AdmondDeng/remote/case/Assem1.SLDASM

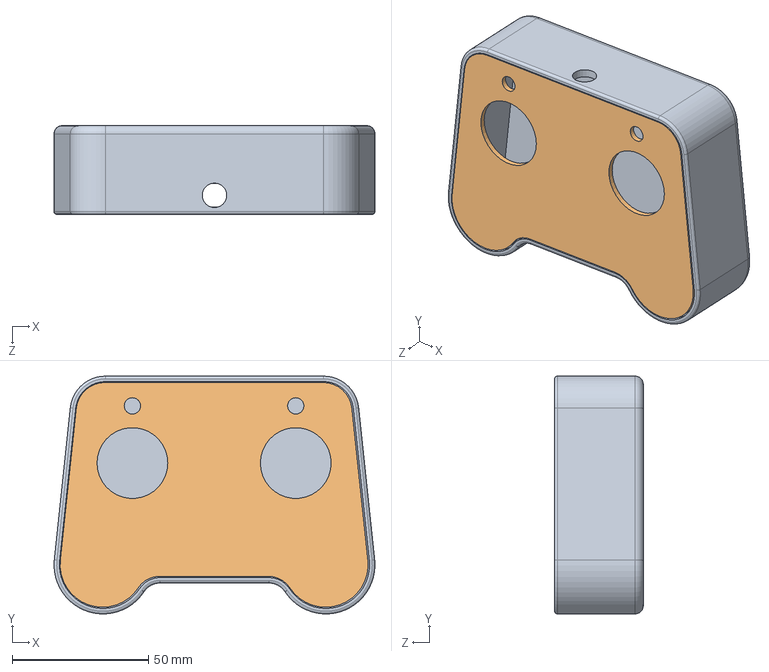
[picture p1: CAD file, 2024-06-24]
case/Assem1.SLDASM
117.9 x 87.3 x 32.6 mm
