AdmondDeng/remote/case/upper.SLDPRT

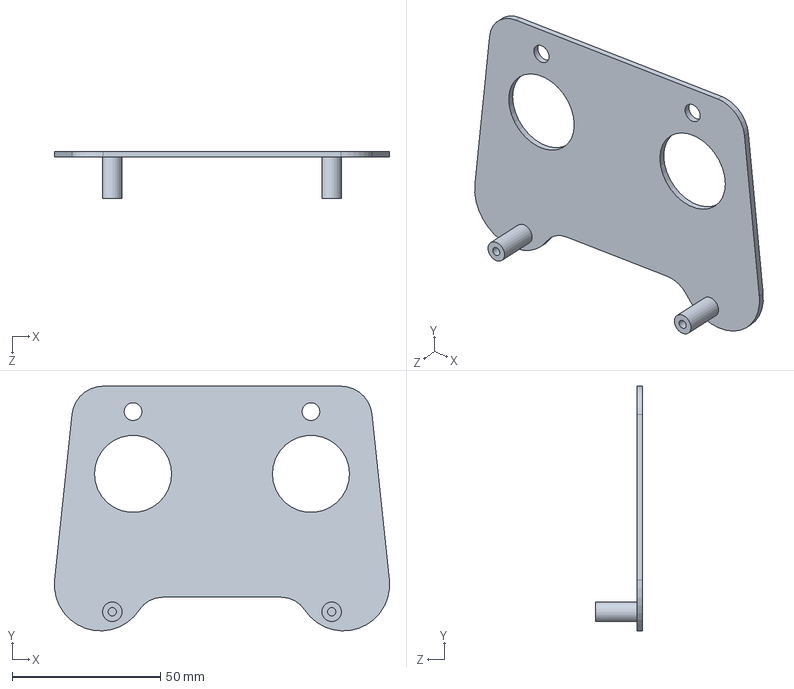
[picture p2: CAD file, 2024-06-24]
case/upper.SLDPRT
113.0 x 82.5 x 16.0 mm
