AdmondDeng/remote/case/lower - backup.SLDPRT

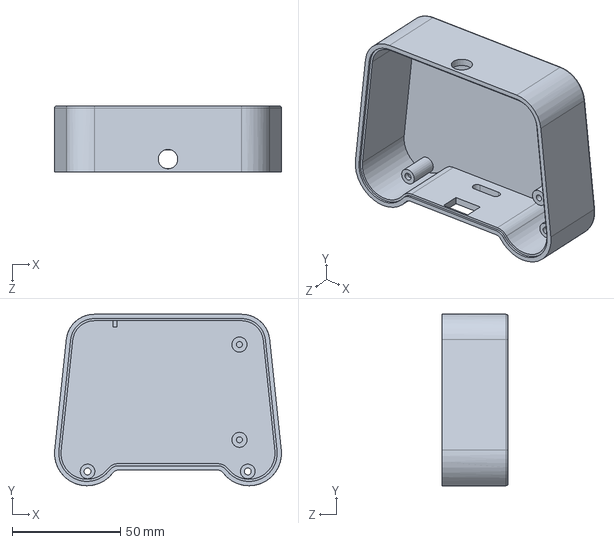
[picture p3: CAD file, 2024-06-24]
case/lower - backup.SLDPRT
104.8 x 79.2 x 30.6 mm
