AdmondDeng/remote/case/lower.SLDPRT

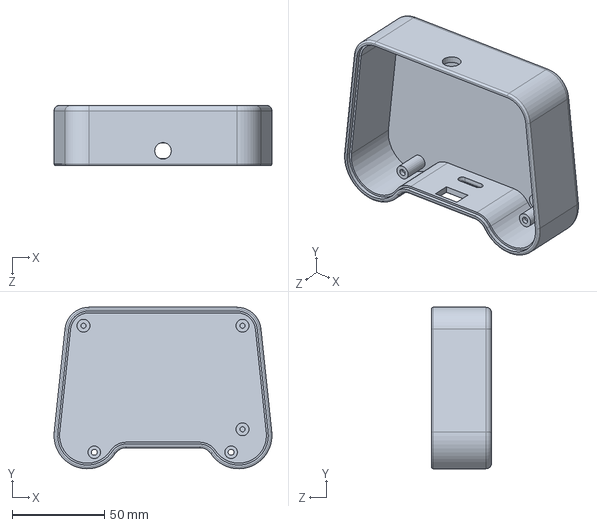
[picture p4: CAD file, 2024-06-24]
case/lower.SLDPRT
117.9 x 87.4 x 32.6 mm
