AdmondDeng/remote/Hw_Transmitter/transmitter/transmitter.kicad_pcb

## KiCad design Hw_Transmitter/transmitter/transmitter.kicad_pcb (2024-06-27)

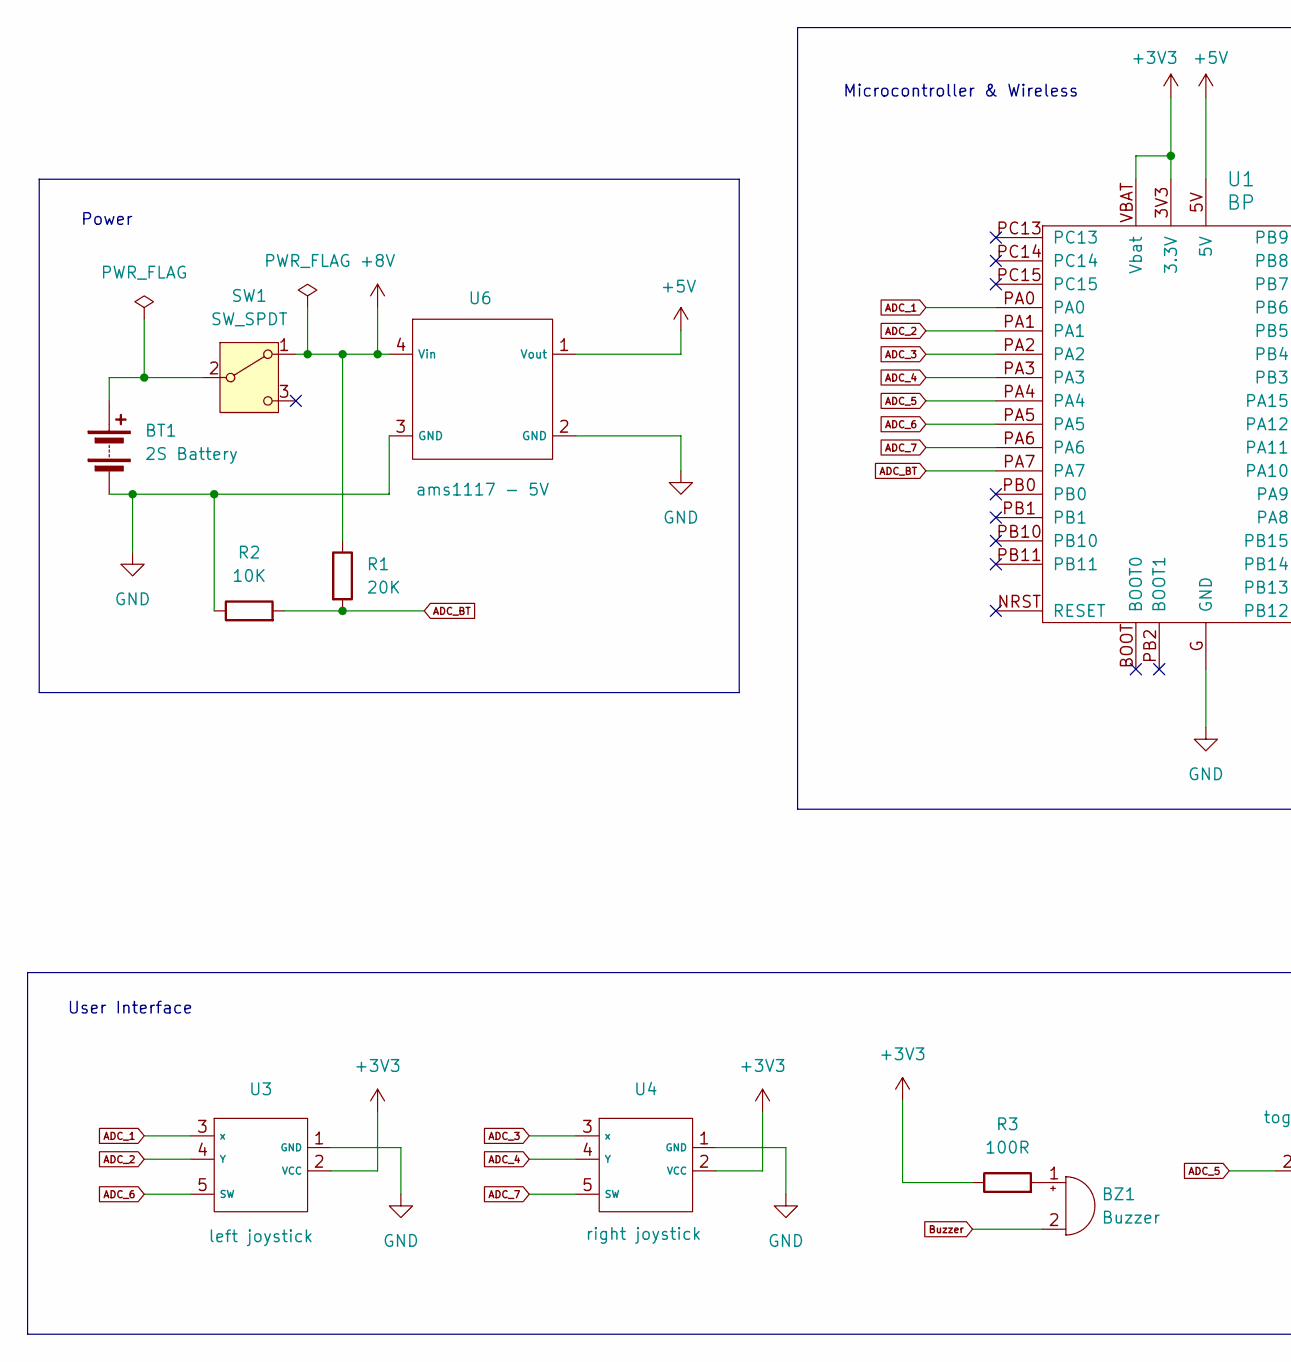
[picture p5: schematic transmitter.kicad_sch, part in row 1, column 1]

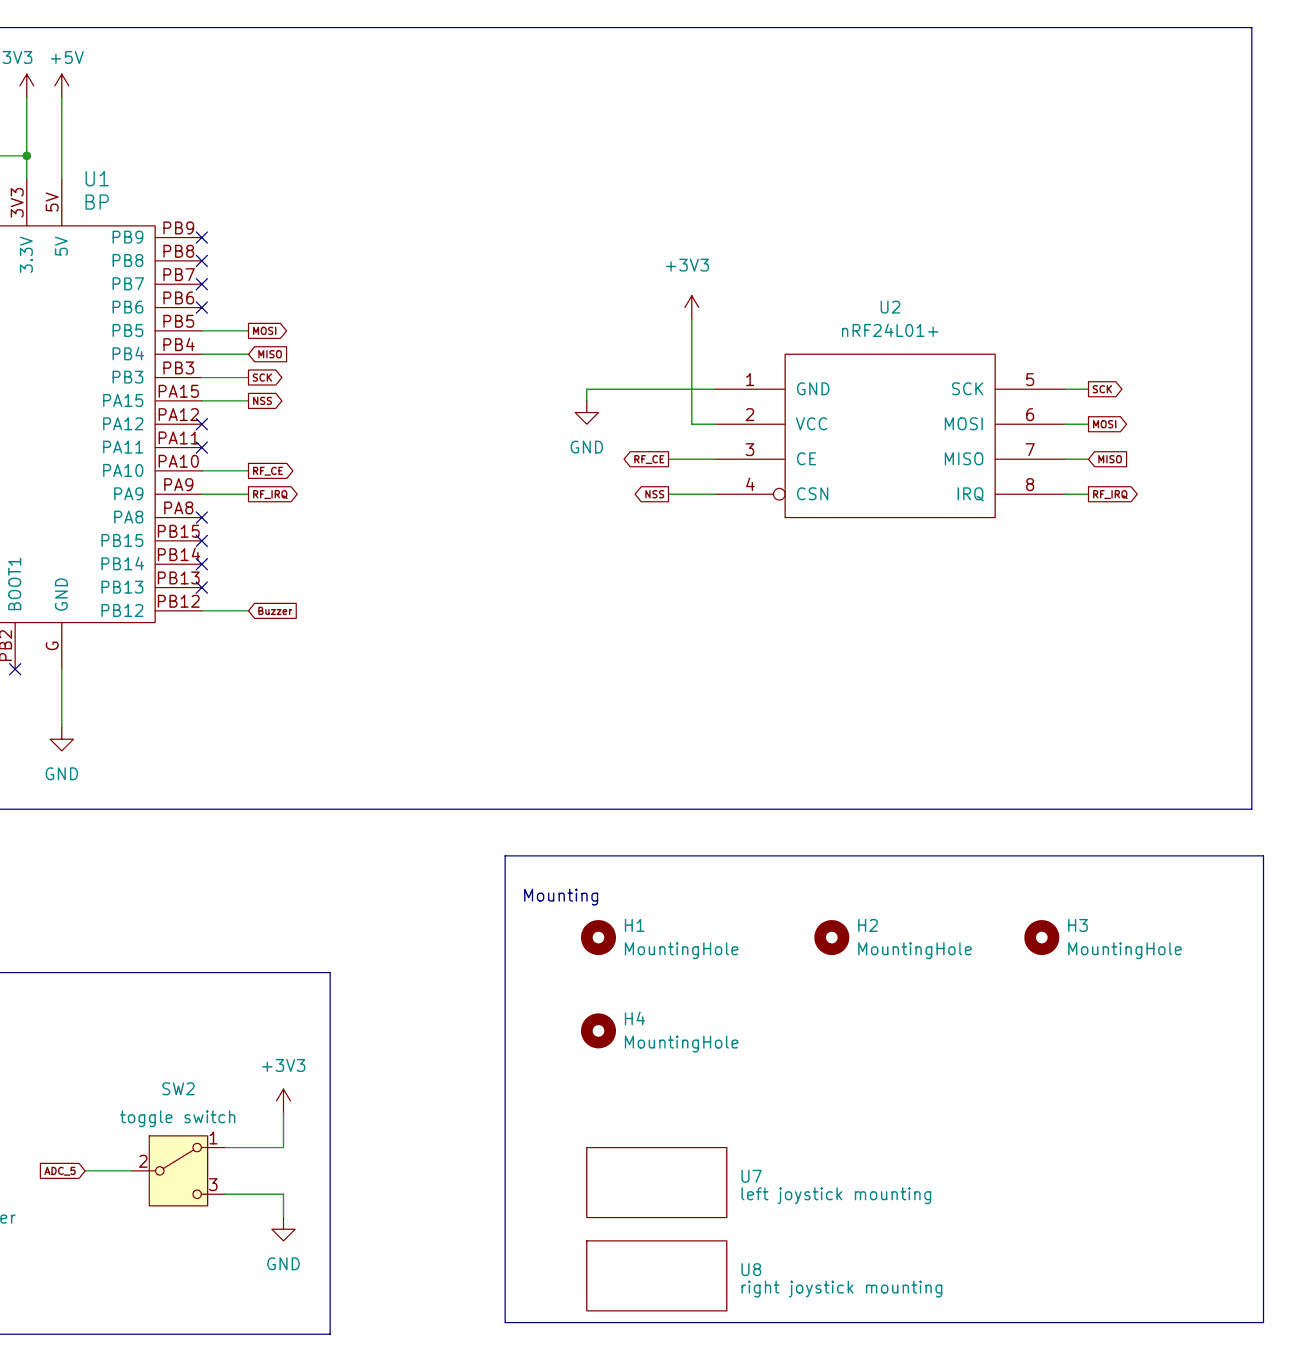
[picture p6: schematic transmitter.kicad_sch, part in row 1, column 2]

Parts:
BT1: 2S Battery; R_2816_7142Metric_Pad3.20x4.45mm_HandSolder
BZ1: Buzzer; buzzer
H1, H2, H3, H4: MountingHole; MountingHole_3.2mm_M3
R1: 20K; R_Axial_DIN0207_L6.3mm_D2.5mm_P10.16mm_Horizontal
R2: 10K; R_Axial_DIN0207_L6.3mm_D2.5mm_P10.16mm_Horizontal
R3: 100R; R_Axial_DIN0207_L6.3mm_D2.5mm_P10.16mm_Horizontal
SW1: SW_SPDT; toggle_switch
SW2: toggle switch; toggle_switch
U1: BP; blue_pill
U2: nRF24L01+; PinHeader_2x04_P2.54mm_Vertical
U3: left joystick; PinHeader_1x05_P2.54mm_Vertical
U4: right joystick; PinHeader_1x05_P2.54mm_Vertical
U6: ams1117 - 5V; ams1117_module
U7: left joystick mounting; joystick_mounting
U8: right joystick mounting; joystick_mounting

Connections:
+3V3: R3.1, SW2.1 (A), U1.3V3 (3.3V), U1.VBAT (Vbat), U2.2 (VCC), U3.2 (VCC), U4.2 (VCC)
+5V: U1.5V, U6.1 (Vout)
+8V: R1.1, SW1.1 (A), U6.4 (Vin)
ADC_1: U1.PA0, U3.3 (x)
ADC_2: U1.PA1, U3.4 (Y)
ADC_3: U1.PA2, U4.3 (x)
ADC_4: U1.PA3, U4.4 (Y)
ADC_5: SW2.2 (B), U1.PA4
ADC_6: U1.PA5, U3.5 (SW)
ADC_7: U1.PA6, U4.5 (SW)
ADC_BT: R1.2, R2.2, U1.PA7
Buzzer: BZ1.2 (-), U1.PB12
GND: BT1.2 (-), R2.1, SW2.3 (C), U1.G (GND), U2.1 (GND), U3.1 (GND), U4.1 (GND), U6.2 (GND), U6.3 (GND)
MISO: U1.PB4, U2.7 (MISO)
MOSI: U1.PB5, U2.6 (MOSI)
NSS: U1.PA15, U2.4 (CSN)
unnamed: BT1.1 (+), SW1.2 (B)
unnamed: BZ1.1 (+), R3.2
RF_CE: U1.PA10, U2.3 (CE)
RF_IRQ: U1.PA9, U2.8 (IRQ)
SCK: U1.PB3, U2.5 (SCK)

Notes on the sheet:
Power
Microcontroller & Wireless
User Interface
Mounting

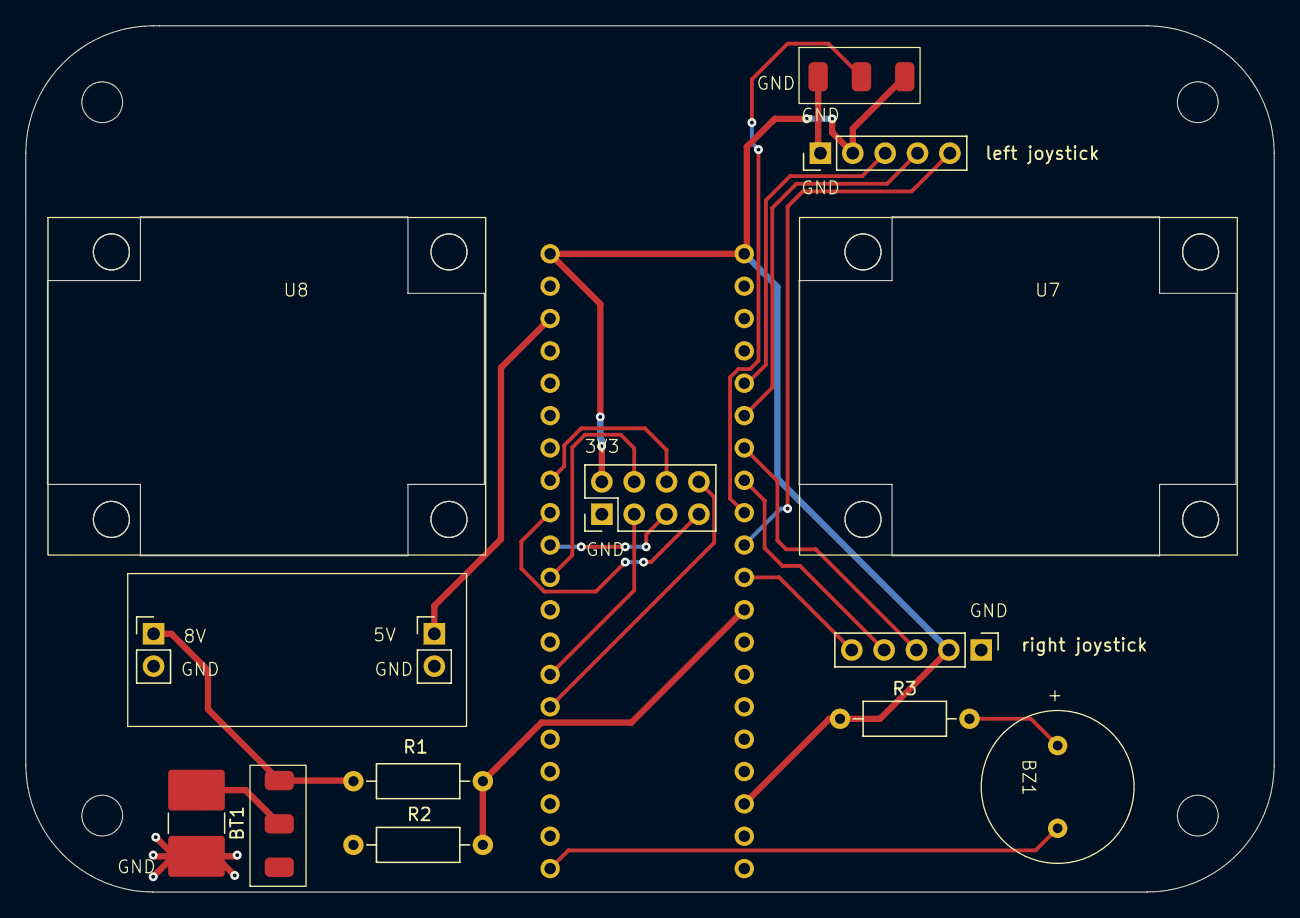
[picture p7: board transmitter.kicad_pcb from above]

Board: 2 copper layers, 98.0 x 68.0 mm, 18 parts (1 on the bottom side), 21 nets.
