AdmondDeng/remote/Hw_Receiver/receiver/receiver.kicad_pcb

## KiCad design Hw_Receiver/receiver/receiver.kicad_pcb (2024-06-24)

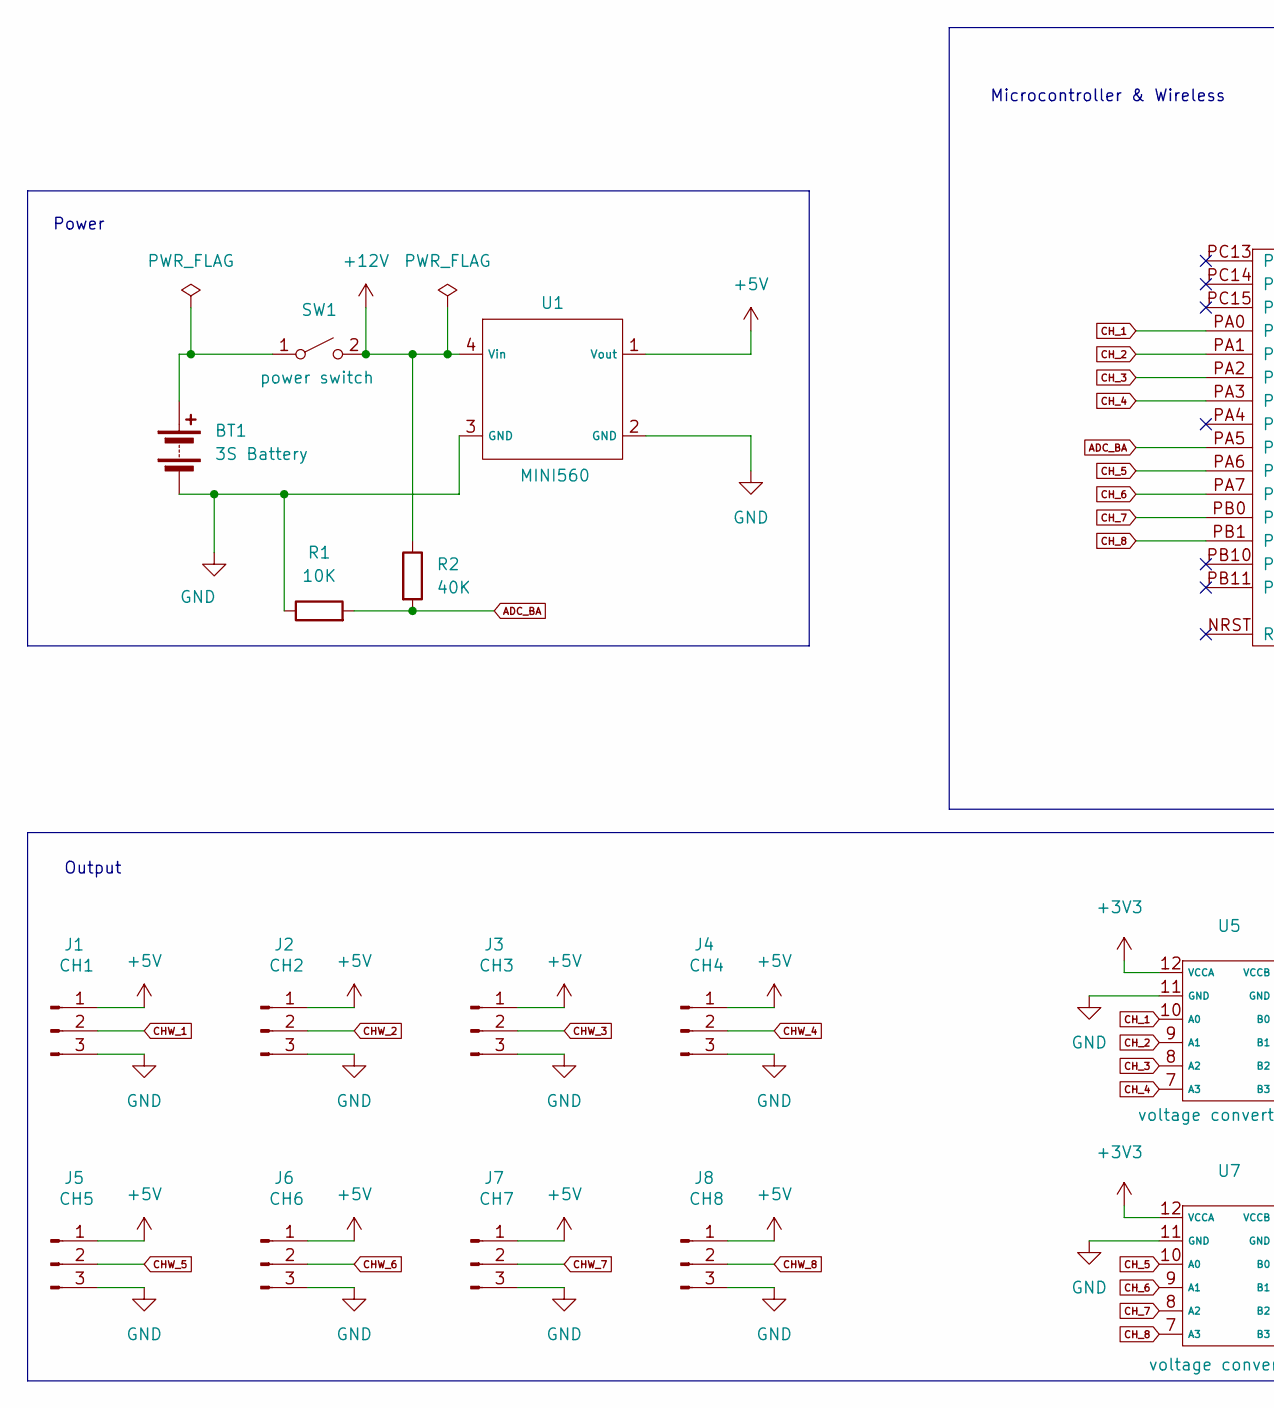
[picture p8: schematic receiver.kicad_sch, part in row 1, column 1]

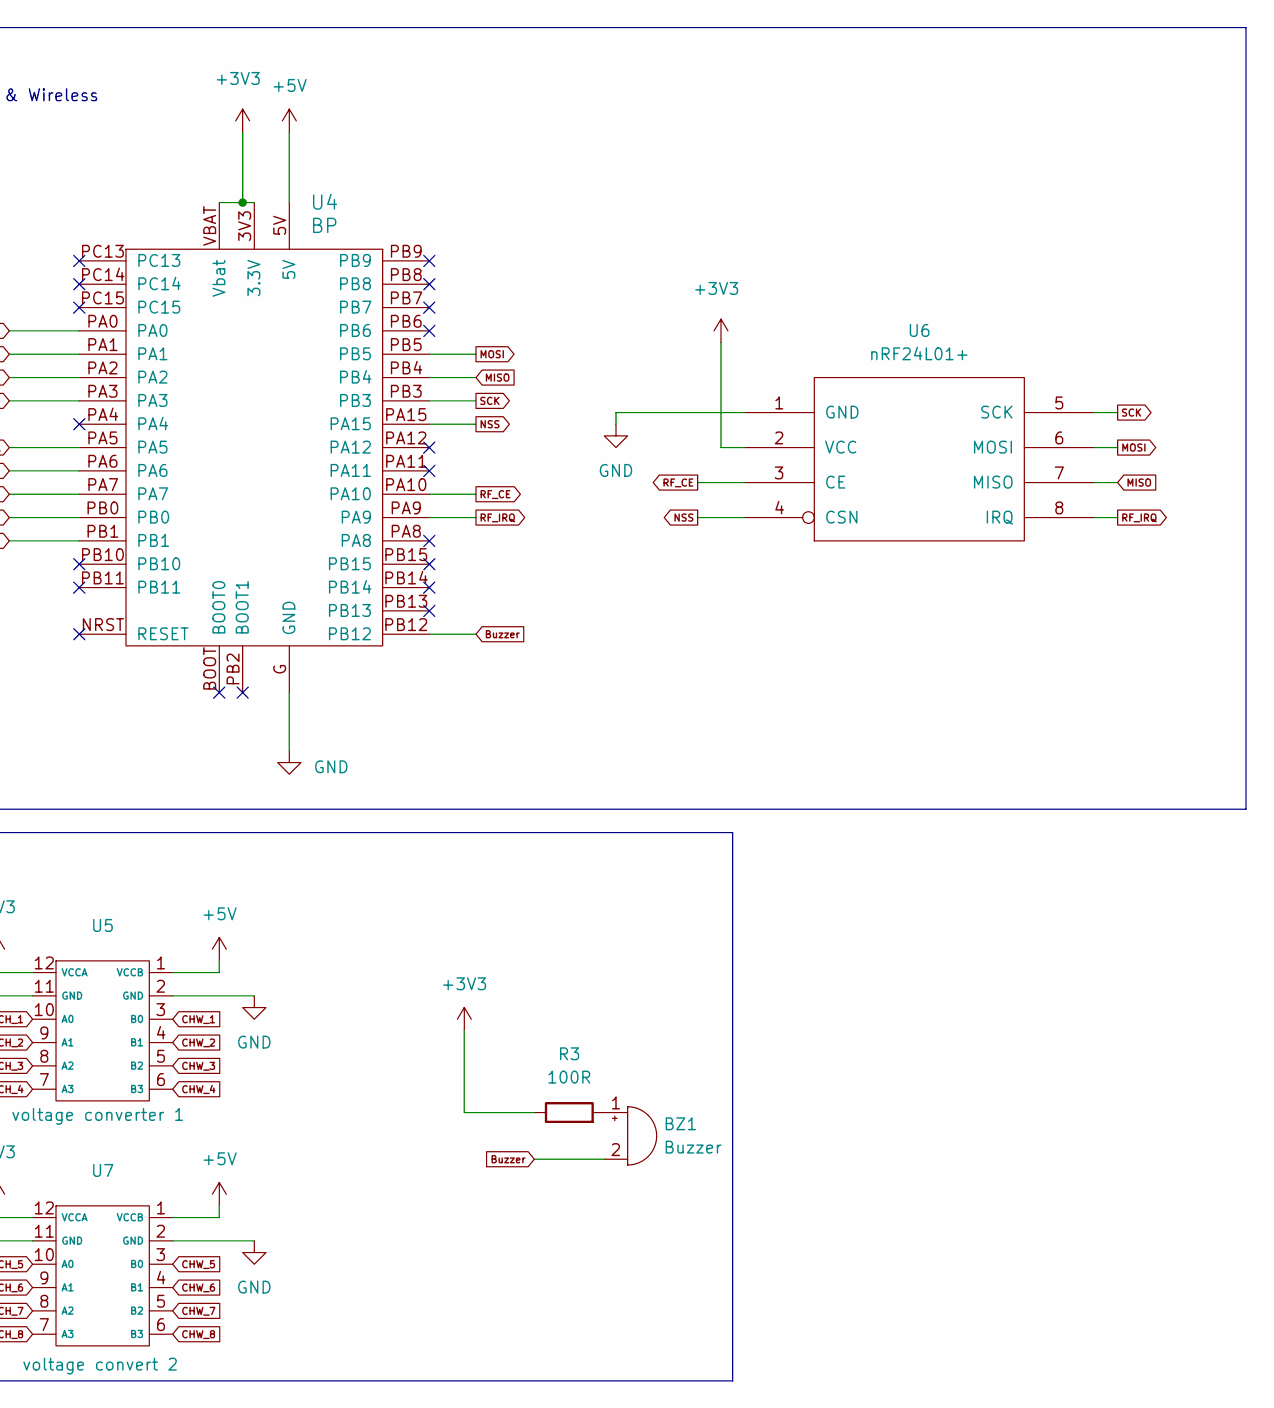
[picture p9: schematic receiver.kicad_sch, part in row 1, column 2]

Parts:
BT1: 3S Battery; R_2816_7142Metric_Pad3.20x4.45mm_HandSolder
BZ1: Buzzer; buzzer
J1: CH1; PinHeader_1x03_P2.54mm_Vertical
J2: CH2; PinHeader_1x03_P2.54mm_Vertical
J3: CH3; PinHeader_1x03_P2.54mm_Vertical
J4: CH4; PinHeader_1x03_P2.54mm_Vertical
J5: CH5; PinHeader_1x03_P2.54mm_Vertical
J6: CH6; PinHeader_1x03_P2.54mm_Vertical
J7: CH7; PinHeader_1x03_P2.54mm_Vertical
J8: CH8; PinHeader_1x03_P2.54mm_Vertical
R1: 10K; R_Axial_DIN0207_L6.3mm_D2.5mm_P10.16mm_Horizontal
R2: 40K; R_Axial_DIN0207_L6.3mm_D2.5mm_P10.16mm_Horizontal
R3: 100R; R_Axial_DIN0207_L6.3mm_D2.5mm_P10.16mm_Horizontal
SW1: power switch; R_2816_7142Metric_Pad3.20x4.45mm_HandSolder
U1: MINI560; mini560
U4: BP; blue_pill
U5: voltage converter 1; 3v_5v_converter
U6: nRF24L01+; PinHeader_2x04_P2.54mm_Vertical
U7: voltage convert 2; 3v_5v_converter

Connections:
+3V3: R3.1, U4.3V3 (3.3V), U4.VBAT (Vbat), U5.12 (VCCA), U6.2 (VCC), U7.12 (VCCA)
+5V: J1.1, J2.1, J3.1, J4.1, J5.1, J6.1, J7.1, J8.1, U1.1 (Vout), U4.5V, U5.1 (VCCB), U7.1 (VCCB)
+12V: R2.1, SW1.2 (B), U1.4 (Vin)
ADC_BA: R1.2, R2.2, U4.PA5
Buzzer: BZ1.2 (-), U4.PB12
CHW_1: J1.2, U5.3 (B0)
CHW_2: J2.2, U5.4 (B1)
CHW_3: J3.2, U5.5 (B2)
CHW_4: J4.2, U5.6 (B3)
CHW_5: J5.2, U7.3 (B0)
CHW_6: J6.2, U7.4 (B1)
CHW_7: J7.2, U7.5 (B2)
CHW_8: J8.2, U7.6 (B3)
CH_1: U4.PA0, U5.10 (A0)
CH_2: U4.PA1, U5.9 (A1)
CH_3: U4.PA2, U5.8 (A2)
CH_4: U4.PA3, U5.7 (A3)
CH_5: U4.PA6, U7.10 (A0)
CH_6: U4.PA7, U7.9 (A1)
CH_7: U4.PB0, U7.8 (A2)
CH_8: U4.PB1, U7.7 (A3)
GND: BT1.2 (-), J1.3, J2.3, J3.3, J4.3, J5.3, J6.3, J7.3, J8.3, R1.1, U1.2 (GND), U1.3 (GND), U4.G (GND), U5.2 (GND), U5.11 (GND), U6.1 (GND), U7.2 (GND), U7.11 (GND)
MISO: U4.PB4, U6.7 (MISO)
MOSI: U4.PB5, U6.6 (MOSI)
NSS: U4.PA15, U6.4 (CSN)
unnamed: BT1.1 (+), SW1.1 (A)
unnamed: BZ1.1 (+), R3.2
RF_CE: U4.PA10, U6.3 (CE)
RF_IRQ: U4.PA9, U6.8 (IRQ)
SCK: U4.PB3, U6.5 (SCK)

Notes on the sheet:
Output
Power
Microcontroller & Wireless

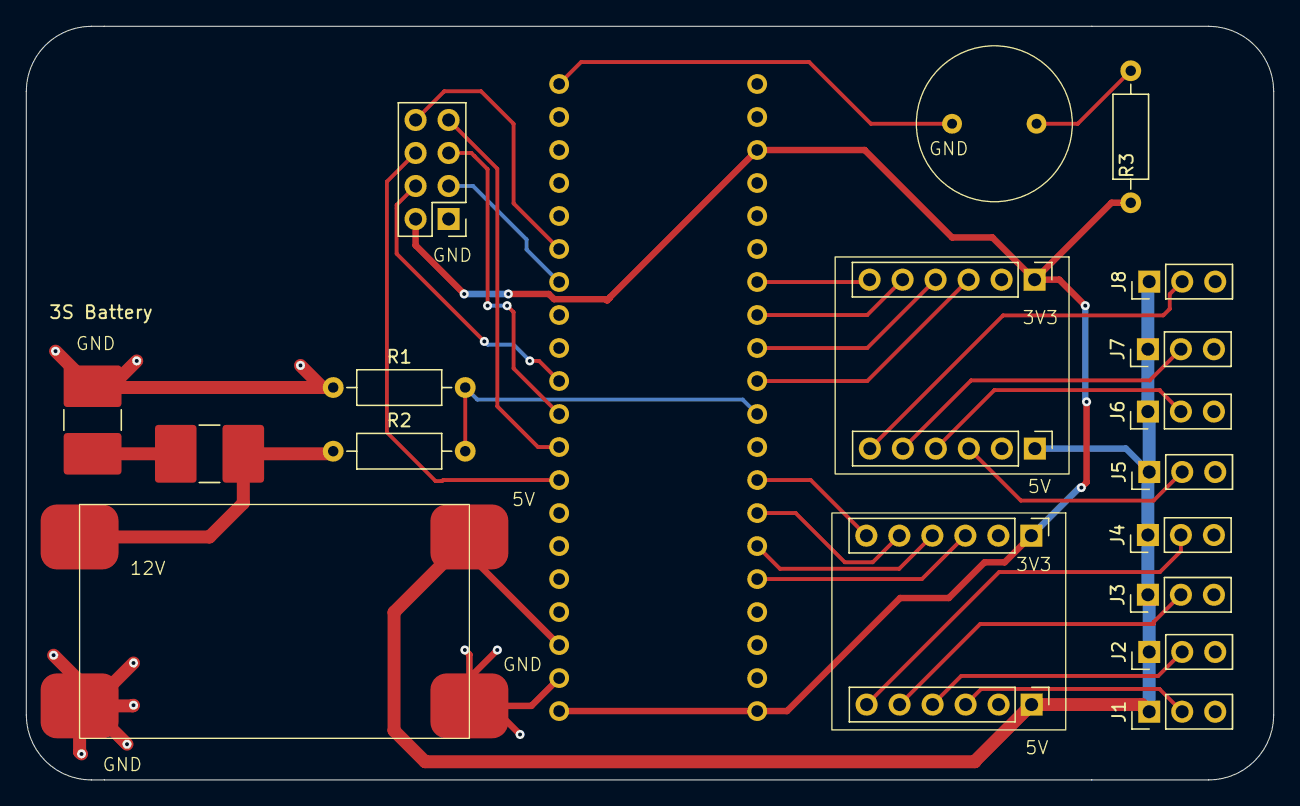
[picture p10: board receiver.kicad_pcb from above]

Board: 2 copper layers, 96.0 x 58.0 mm, 19 parts (0 on the bottom side), 30 nets.
