AdmondDeng/remote/receiver_c8/Core/Src/main.c

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
/* Includes ------------------------------------------------------------------*/
#include "main.h"
#include "spi.h"
#include "tim.h"
#include "gpio.h"

/* USER CODE BEGIN Includes */
#include "nrf24l01p.h"
/* USER CODE END Includes */

/* USER CODE BEGIN PD */
#define ADC_DATA_SIZE	8
#define MAGIC_REMOTE	'R'
#define MAGIC_USB		'U'
/* USER CODE END PD */


/* USER CODE BEGIN PV */
static uint32_t buzzer_count;
/* USER CODE END PV */

void SystemClock_Config(void);
/* USER CODE BEGIN 0 */
uint8_t rx_data[NRF24L01P_PAYLOAD_LENGTH] = { 0, };
uint16_t adc_data[ADC_DATA_SIZE];

#define MAX_PWM_COUNT		14000

#define PWM_PERIOD			14
#define PWM_PERIOD_ZERO		1.0
#define PWM_PERIOD_MAX		2.0

#define MAX_ADC_VALUE		4095

void setup_channel(int ch, int data)
{
	float mapped_value = 1.0 * (PWM_PERIOD_MAX - PWM_PERIOD_ZERO) * data / MAX_ADC_VALUE;
	mapped_value += PWM_PERIOD_ZERO;

	float pwm_percent = mapped_value / PWM_PERIOD;
	uint16_t timer_count = pwm_percent * MAX_PWM_COUNT;

	switch (ch)
	{
	case 0:
		htim2.Instance->CCR1 = timer_count;
		break;
	case 1:
		htim2.Instance->CCR2 = timer_count;
		break;
	case 2:
		htim2.Instance->CCR3 = timer_count;
		break;
	case 3:
		htim2.Instance->CCR4 = timer_count;
		break;
	case 4:
		htim3.Instance->CCR1 = timer_count;
		break;
	case 5:
		htim3.Instance->CCR2 = timer_count;
		break;
	case 6:
		htim3.Instance->CCR3 = timer_count;
		break;
	case 7:
		htim3.Instance->CCR4 = timer_count;
		break;
	}
}

// NRF24L01 received one message --> IRQ handler --> adjust PWM width

// for RX interrupt
void HAL_GPIO_EXTI_Callback(uint16_t GPIO_Pin)
{
	if(GPIO_Pin == NRF24L01P_IRQ_PIN_NUMBER)
	{
		nrf24l01p_rx_receive(rx_data); // read data when data ready flag is set

		if (rx_data[0] == MAGIC_REMOTE)
		{
			for (int i = 1; i <= 16; i ++)
			{
				((uint8_t *)adc_data)[i - 1] = rx_data[i];
			}

			for (int i = 0; i < 8; i ++)
			{
				setup_channel(i, adc_data[i]);
			}
		}
	}
}

void HAL_TIM_PeriodElapsedCallback(TIM_HandleTypeDef *htim)
{
	if (htim == &htim4)
	{
		if (buzzer_count > 0)
		{
			buzzer_count --;
			HAL_GPIO_TogglePin(GPIOB, GPIO_PIN_12);
		}
	}
}

void buzz(int milliseconds)
{
	// 500HZ --> 2ms
	// use toggle to control GPIO pin, should multiply 2

	buzzer_count = milliseconds;
}
/* USER CODE END 0 */

/**
  * @brief  The application entry point.
  * @retval int
  */
int main(void)
{

  /* MCU Configuration--------------------------------------------------------*/

  /* Reset of all peripherals, Initializes the Flash interface and the Systick. */
  HAL_Init();

  /* Configure the system clock */
  SystemClock_Config();

  /* Initialize all configured peripherals */
  MX_GPIO_Init();
  MX_SPI1_Init();
  MX_TIM2_Init();
  MX_TIM3_Init();
  MX_TIM4_Init();
  /* USER CODE BEGIN 2 */
  nrf24l01p_rx_init(2500, _250kbps);

  HAL_TIM_PWM_Start(&htim2, TIM_CHANNEL_1);
  HAL_TIM_PWM_Start(&htim2, TIM_CHANNEL_2);
  HAL_TIM_PWM_Start(&htim2, TIM_CHANNEL_3);
  HAL_TIM_PWM_Start(&htim2, TIM_CHANNEL_4);

  HAL_TIM_PWM_Start(&htim3, TIM_CHANNEL_1);
  HAL_TIM_PWM_Start(&htim3, TIM_CHANNEL_2);
  HAL_TIM_PWM_Start(&htim3, TIM_CHANNEL_3);
  HAL_TIM_PWM_Start(&htim3, TIM_CHANNEL_4);

  HAL_TIM_Base_Start_IT(&htim4);

  buzz(1000);

  /* USER CODE END 2 */

  /* Infinite loop */
  /* USER CODE BEGIN WHILE */
  while (1)
  {
    /* USER CODE END WHILE */

    /* USER CODE BEGIN 3 */
  }
  /* USER CODE END 3 */
}

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
