AdmondDeng/remote/receiver_c8/receiver_c8.ioc

Mcu.UserName=STM32F103C8Tx
PA0-WKUP.Signal=S_TIM2_CH1_ETR
PA1.Signal=S_TIM2_CH2
PA10.GPIO_Label=RF_CE
PA10.Signal=GPIO_Output
PA13.Signal=SYS_JTMS-SWDIO
PA14.Signal=SYS_JTCK-SWCLK
PA15.GPIO_Label=NSS
PA15.Signal=GPIO_Output
PA2.Signal=S_TIM2_CH3
PA3.Signal=S_TIM2_CH4
PA6.Signal=S_TIM3_CH1
PA7.Signal=S_TIM3_CH2
PA9.GPIO_Label=RF_IRQ
PA9.Signal=GPXTI9
PB0.Signal=S_TIM3_CH3
PB1.Signal=S_TIM3_CH4
PB12.Signal=GPIO_Output
PB3.Signal=SPI1_SCK
PB4.Signal=SPI1_MISO
PB5.Signal=SPI1_MOSI
PC13-TAMPER-RTC.GPIO_Label=LED
PC13-TAMPER-RTC.Signal=GPIO_Output
PC14-OSC32_IN.Signal=RCC_OSC32_IN
PC15-OSC32_OUT.Signal=RCC_OSC32_OUT
PD0-OSC_IN.Signal=RCC_OSC_IN
PD1-OSC_OUT.Signal=RCC_OSC_OUT
