AdmondDeng/remote/transmitter_c8/Core/Inc/main.h

#define LED_Pin GPIO_PIN_13
#define LED_GPIO_Port GPIOC
#define Test_Pin GPIO_PIN_10
#define Test_GPIO_Port GPIOB
#define Buzzer_Pin GPIO_PIN_12
#define Buzzer_GPIO_Port GPIOB
#define RF_IRQ_Pin GPIO_PIN_9
#define RF_IRQ_GPIO_Port GPIOA
#define RF_IRQ_EXTI_IRQn EXTI9_5_IRQn
#define RF_CE_Pin GPIO_PIN_10
#define RF_CE_GPIO_Port GPIOA
#define NSS_Pin GPIO_PIN_15
#define NSS_GPIO_Port GPIOA
