AdmondDeng/remote/(commit log)

2024-06-27 1. transmitter: replace ams1117-3.3V with ams1117-5V. 2. remove backup files and update git ignore file.
    [transmitter.kicad_pcb, transmitter.kicad_sch]
2024-06-28 bug fix for nrf24l01p library.
    [nrf24l01p.c]
2024-06-30 for transmitter: buzz when battery voltage goes below 6.6V
    [main.c]
