AdmondDeng/remote/(notices)

Notices in the files:
receiver_c8/Core/Src/main.c:
Copyright (c) 2024 STMicroelectronics.
All rights reserved.
This software is licensed under terms that can be found in the LICENSE file
